filiko/testSieveSorter/docs/SYSTEM.md

# The system: read this first

The one description of what we're building. **If a brief, a doc or the code disagrees with this file, this file wins.** Facts come from the user and the team's photos (Oct 25, 2026), and assumptions are marked. What has been tested, and what hasn't, is in [EVIDENCE.md](EVIDENCE.md).

## 1. The job
- **Input:** a Malaise-trap sample. It's thousands of mostly tiny flies in ethanol, and often a **compacted clump**: a ball or mound of tangled insects, mixed with **leaves, twigs and dirt**.
- **Step 1, the real point of the system:** **break the clump apart, gently.** Specimens go on to imaging and DNA barcoding, so crushed bodies or snapped legs are failures.
- **Step 2:** **size-sort** the freed specimens into classes. BugPicker's are > 6 mm, 2–6 mm and < 2 mm. Leaves are held back on top; dirt goes to the bottom.
- Pasta, rice and quinoa are the bench surrogates for the size classes.

Details: [docs/sessions/clump-breakup.md](sessions/clump-breakup.md).

## 2. The hardware: separate trays, one above the other
- **The stack:** separate holder boxes (about 140 × 104 × 25 mm), each holding one sieve insert (131.4 × 95.4 mm). Coarse is on top, finer below, and a catch pan at the bottom. The breaker layer (step 1) goes on top.
- **The boxes are separate**, stacked one above the other. They aren't one block, and they aren't side by side.

## 3. The motion: each box shakes on its own; sifting is what counts
- **Updated by the user, Oct 27:** "the boxes are individually shaking, it doesn't matter that they're synced, what matters is the sifting." Each box can have its own motion: tilt, vibration, direction, phase. Syncing and alternating aren't requirements. The optimizer picks each box's motion for the best sifting (`sim/BOXES.md`, the `sift` study), with the insects wet (`sim/LIQUID.md`). The hardware then follows the winning motion: one small actuator per box, or a shared drive if the winner allows it.
- **The seesaw below is one option it can choose,** not a constraint. It was the hackathon's working model:
  - **Seesaw, ends tip.** Each tray rocks about **its own pivot across its middle**: a horizontal axis along the tray's width (Y), through its centre. The two short ends (−X and +X) go up and down in turn. **The angle:** **±10° is the default; sweep 5–15°.** ±25° looked too wide in the replays, so don't use 20–30°. Grains slide end to end across the sieve, as in a gold pan; rice on plastic starts sliding at about 22°.
  - **Each level has its own pivot, and neighbours alternate:** opposite phase, so when one tray tips its −X end down, the trays above and below tip it up. The user chose this so material doesn't fly off. Whatever drops from a level lands on a tray tilted the other way.
- **Consequence for the hardware:** when neighbours tilt opposite ways, their facing ends close in by about L·sin θ (L ≈ 140 mm: 48 mm at 20°, 59 mm at 25°, 70 mm at 30°). Measured on the real holder solid (`cad/seesaw_tower.py`, PR #14, 3 mm clearance, pivot assumed at the box centre). The **+X mounting tab** decides the spacing:

  | Tilt | Pitch with the tab | Tab cut off |
  |---|---|---|
  | ±20° | 89.5 mm | 74.4 mm |
  | ±25° | 103.6 mm | 84.9 mm |
  | ±30° | 116.7 mm | 94.7 mm |

  A middle pivot doesn't need the tab, so the seesaw holder (`cad/seesaw_holder.py`) has none. **The build hangs its levels 55 mm apart at ±10°** (`cad/WORKING_DIMENSIONS.md` has the table for every tilt). The sim checks that trays never touch at either end.
- **Not known yet (ASSUMED; sweep them):**
  - the best angle (default ±10°; search 5–15°);
  - the period (the optimizer's seesaw uses 0.4–6 s per cycle);
  - the motion profile: constant angular speed with hard reversals (as the firmware drives its stage) or a smooth sine.
- **Superseded:** earlier notes in this file (rigid up-and-down translation, then "yaw about the +X tab") and the optimizer's default `rock_axis: x` (long sides tipping). The axis is **Y** (the ends tip). The pure translation strokes (`angle_deg`, the firmware stroke, VERTICAL.md, the leaderboards before 10:50) are simplifications; re-check them under the seesaw before the pitch quotes them.

## 3b. The drive for the alternating seesaw (proposed, not built)
This drive only fits the alternating seesaw. If the `sift` study's winning motions differ per box, each box gets its own actuator instead.
- **Two push rods hang from BugSorter's one linear stage.** Rod A, at x = +R, drives levels 0 and 2; rod B, at x = −R, drives levels 1 and 3. Both run on the +Y side, outside the boxes.
- **Why they alternate:** when the stage rises, the levels on rod A lift their +X ends and the levels on rod B lift their −X ends, so neighbours tilt opposite ways.
- **The angle comes from the stroke:** θ = atan(stroke / 2R). It's atan because each rod's cross-pin rides a slot fixed in the box while the rod stays vertical. With R = 56.7 mm, the firmware's default 2 cm stroke gives ±10°. The web app's top and bottom positions set the angle, and its speed sets the period (2 × stroke / speed).
- **Cap the stroke.** At 55 mm spacing, neighbouring boxes touch at a 25.4 mm stroke (±12.6°). Keep it at or under 22.7 mm (±11.3°) for a 3 mm gap. Bigger angles need more spacing: 65 mm for ±15°.
- **The buzz:** a tactile transducer on the rods' yoke, driven by `pi/buzz.py`. It reaches the boxes as a small fast rock (about ±0.35°), not the straight-up shake the sim's best runs used. Mounting it on the base plate would match the sim.
- Geometry, parts and assumptions: [cad/PRODUCT.md](../cad/PRODUCT.md). The sim doesn't model the drive: it prescribes each level's angle directly (section 5).

## 4. Liquid
Samples are in ethanol, and the rig sprays from fixed jets above. `sim/spray.py` models push, wetting and capillary adhesion. Wetting should also weaken clump bonds. `sim/liquid.py` puts the sorter in a bath with a lab-fixed surface (buoyancy, drag, added mass, wetting; `--liquid`); how much of the liquid moves with each shaken box (`entrain`) is unknown and swept ([sim/LIQUID.md](../sim/LIQUID.md)). A bath is slow, though: under ethanol the < 2 mm specimens sink at about 1.4 mm/s, so a submerged tower needs minutes per sort, as EntoSieve's 6 min per plate does (LIQUID.md, "A bath is slow"). The `sift` study sorts wet the way BugSorter does: trays in air, the specimens wet from the sample, the jets spraying ethanol, at a light and a strong capillary cling.

## 5. What the sim models, and what it doesn't
- **Modelled:** the trays (with their real mount point and rocking), the particles (specimens, grains, clumps, debris), the stroke, the spray and, optionally, the liquid bath (no flow solver).
- **Not modelled:** the tool, the motor, the frame, the hand. The frame in the replay (`sim/rig.py`) is display only.
- **The seesaw in the sim:** levels rock **differently** (alternating), so one shared non-inertial tray frame can't do it, and neither can the optimizer's current `rocking()` wrapper, which turns every particle in phase.
  - Run seesaw cases in the **lab frame**, with **each level its own body on a hinge** (axis Y through the level's centre).
  - Prescribe its angle kinematically: write the hinge `qpos` / `qvel` each step from θ_k(t) = ±Θ·profile(t), the sign alternating by level. Gravity stays −Z.
  - Then contacts see the real tray velocities, and nothing approximates the rotation.
  - Translation strokes keep the existing tray-frame path.
- **Recording, so the replay shows each level rocking:**
  - `level_q`: frames × levels × 4 (w x y z), each level's orientation in the lab;
  - `scene["levels"][k]`: that level's `pivot` (mm) and the ids of the geoms that belong to it.
  - The format the viewer reads:
    - `level_q`: frames × levels × 4, w x y z;
    - `scene["levels"][k] = {"pivot": [x, y, z] mm, "geoms": [indices into scene["tray"]["geoms"]]}`;
    - in a lab-frame run, `tray_d` = 0.
  - The display rig (`sim/rig.py`) now hangs each tray on an axle across its middle.
- **Clumps** (clump session): `sim/clumps.py`. Specimens are joined by breakable bonds (`eq_active` off above a force that drops with wetness), with a minimal hook in `sorter.py`'s step loop. Debris: leaf / twig / dirt. See clump-breakup.md part A.
- **The sim ranks designs; it does not predict real percentages until it's calibrated against bench counts.**

## How the work was split
During the hackathon, separate Claude Code sessions owned the seesaw, clumps, the optimizer, CAD and viewing, and physics. Each had its own git worktree. Their briefs are kept in [sessions/](sessions/) as a record.
