filiko/testSieveSorter/cad/out/clamp_ring.png

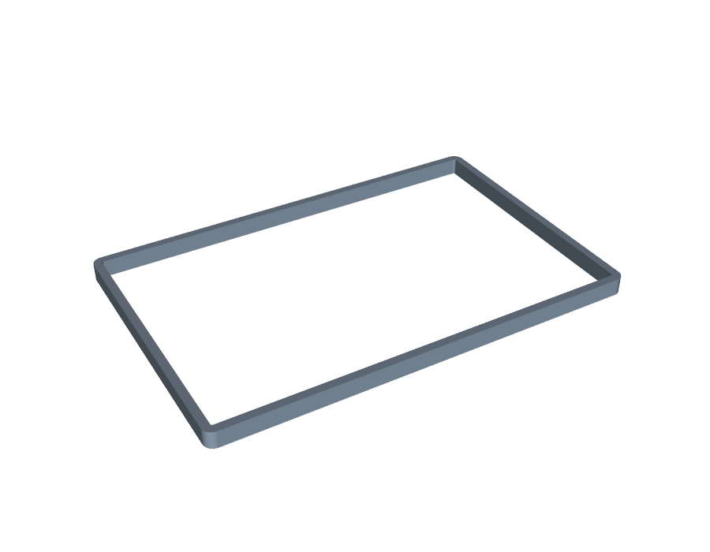
cad/out/clamp_ring.png
