filiko/testSieveSorter/cad/out/gate_t1p2.png

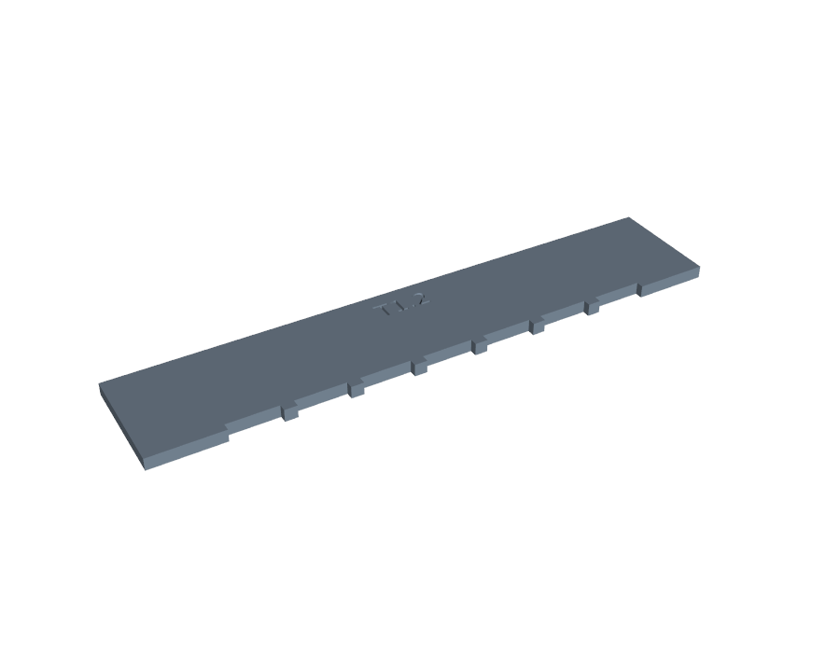
cad/out/gate_t1p2.png
