filiko/testSieveSorter/cad/out/gated_container.png

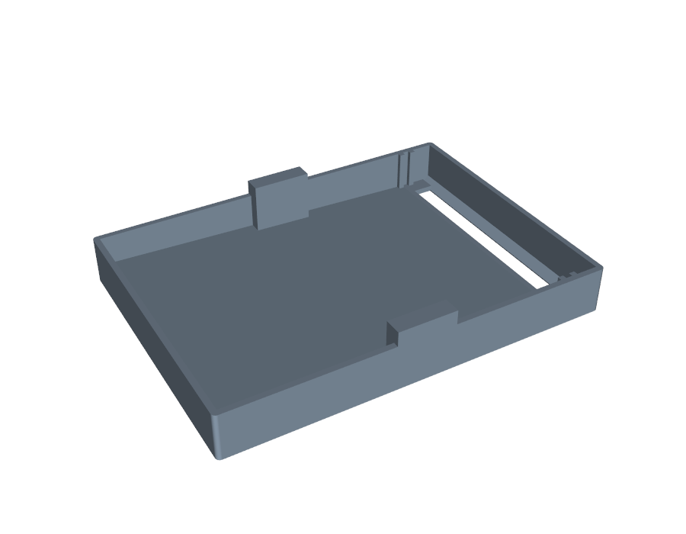
cad/out/gated_container.png
