filiko/testSieveSorter/cad/out/hole_gauge.png

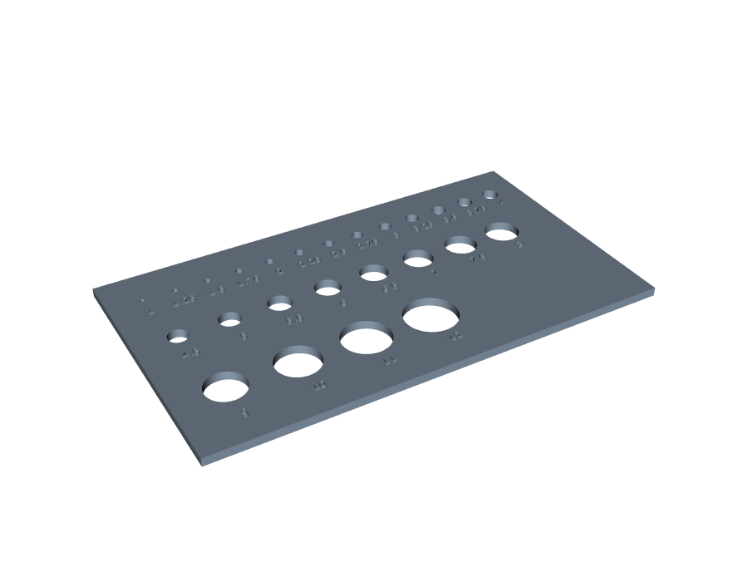
cad/out/hole_gauge.png
