filiko/testSieveSorter/cad/out/layer_1_rods_5p0.png

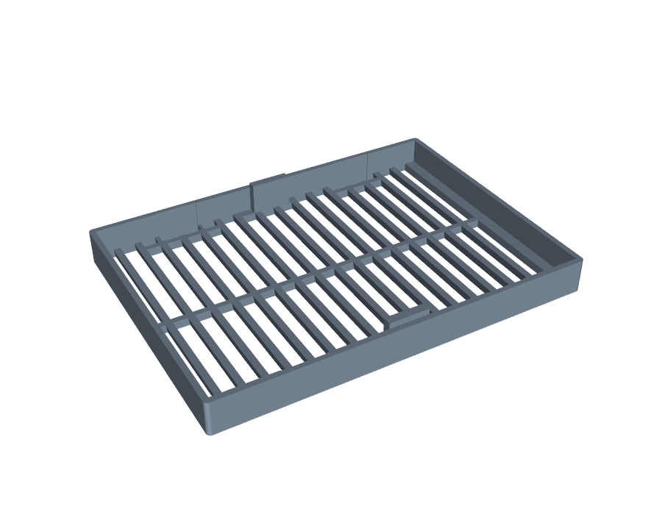
cad/out/layer_1_rods_5p0.png
