filiko/testSieveSorter/cad/out/layer_2_rods_1p4.png

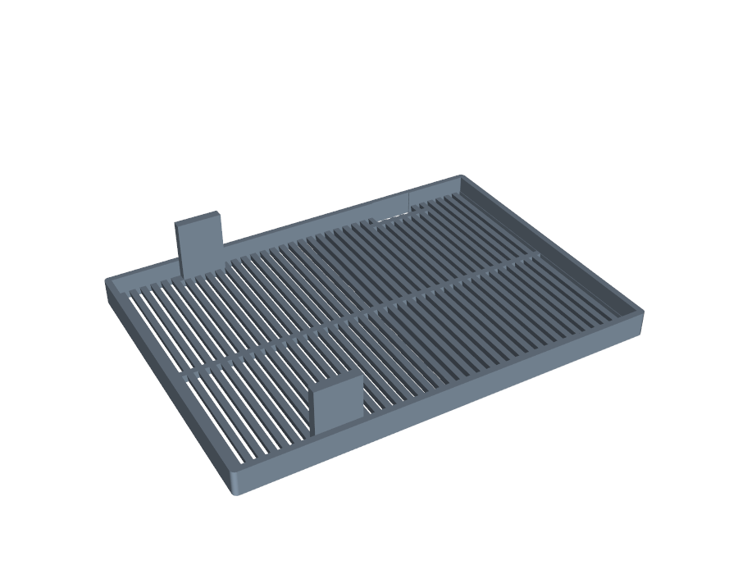
cad/out/layer_2_rods_1p4.png
