filiko/testSieveSorter/cad/out/layer_3_catch.png

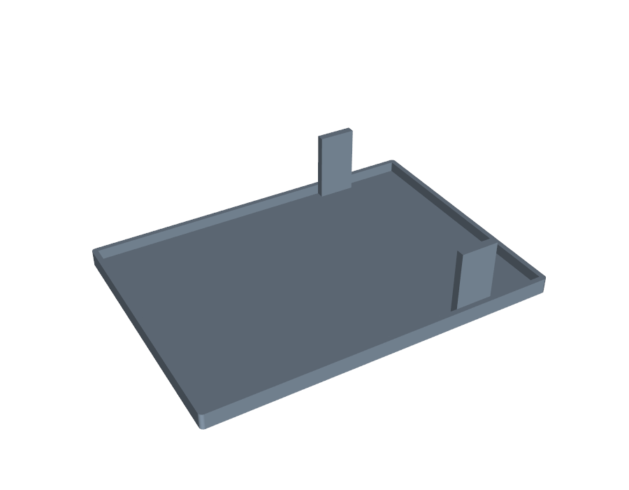
cad/out/layer_3_catch.png
