filiko/testSieveSorter/cad/out/layer_x_square_5p0.png

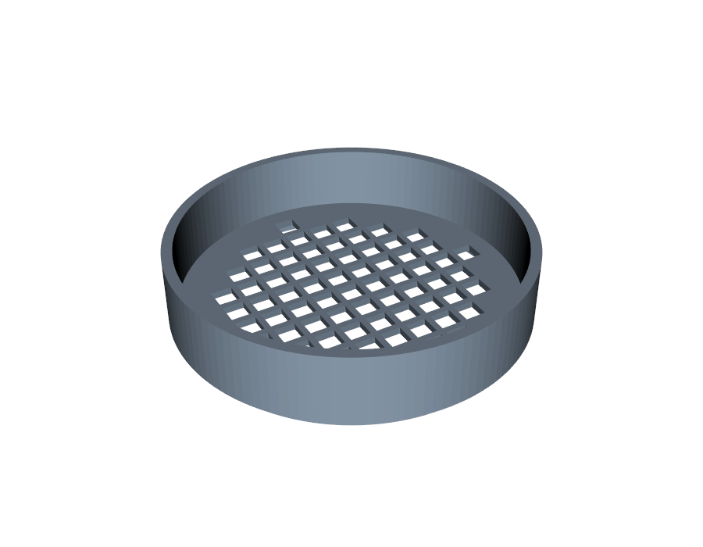
cad/out/layer_x_square_5p0.png
