filiko/testSieveSorter/cad/out/layer_y_square_2p3.png

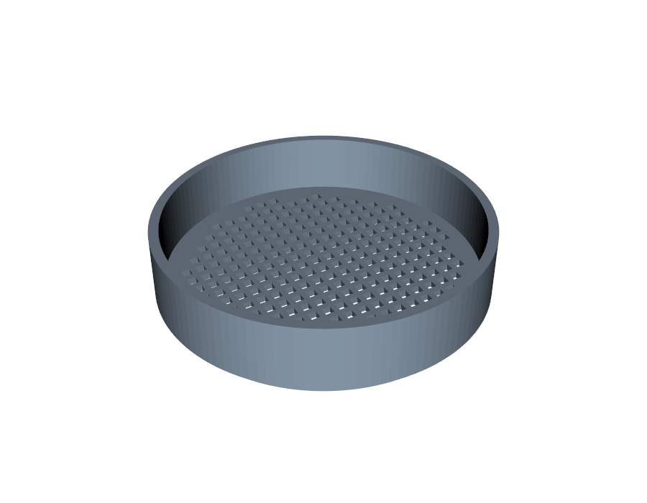
cad/out/layer_y_square_2p3.png
