filiko/testSieveSorter/cad/out/malaise_win1_breaker_o11p3_b1p6_d3p1_h8_p8p5_round.png

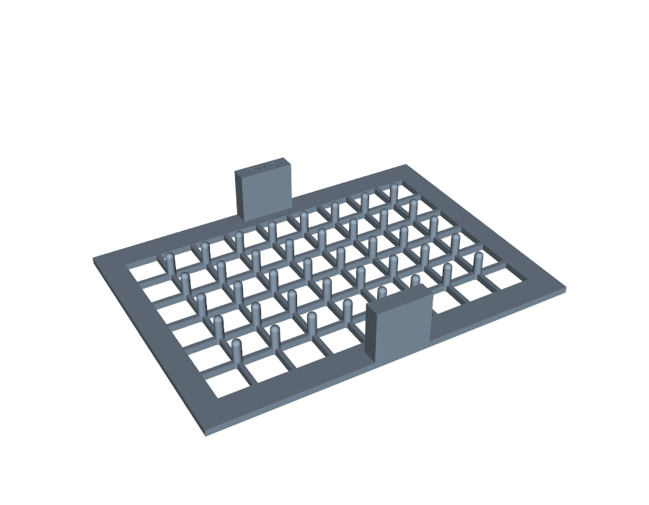
cad/out/malaise_win1_breaker_o11p3_b1p6_d3p1_h8_p8p5_round.png
