filiko/testSieveSorter/cad/out/malaise_win3_breaker_o11p4_b2p3_d1p4_h6p8_p8_round.png

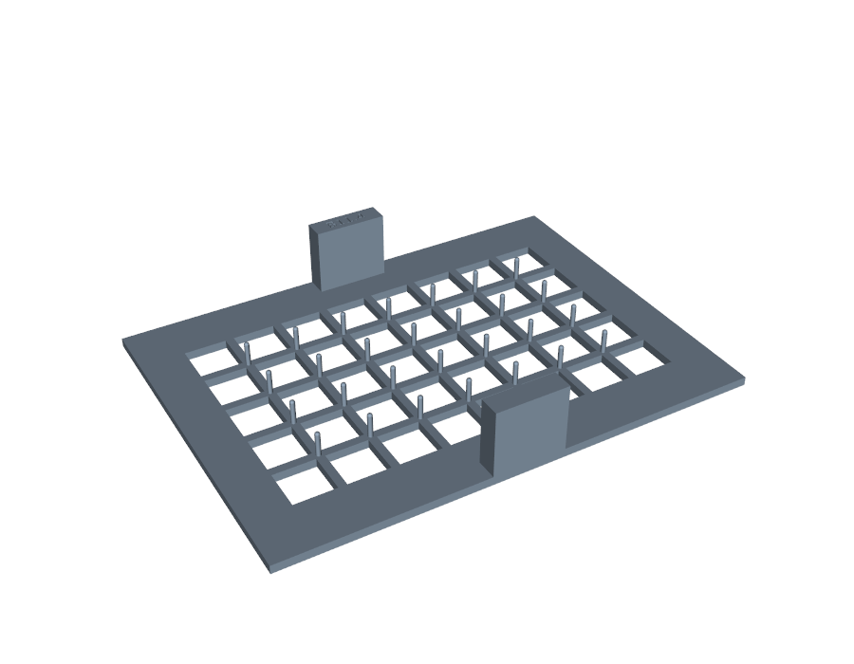
cad/out/malaise_win3_breaker_o11p4_b2p3_d1p4_h6p8_p8_round.png
