filiko/testSieveSorter/cad/out/pool_coupon.png

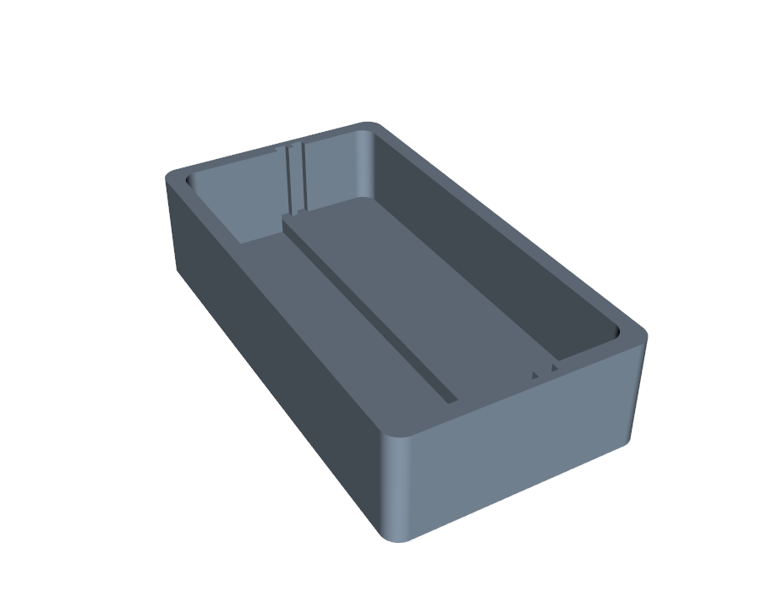
cad/out/pool_coupon.png
