filiko/testSieveSorter/cad/out/product_base.png

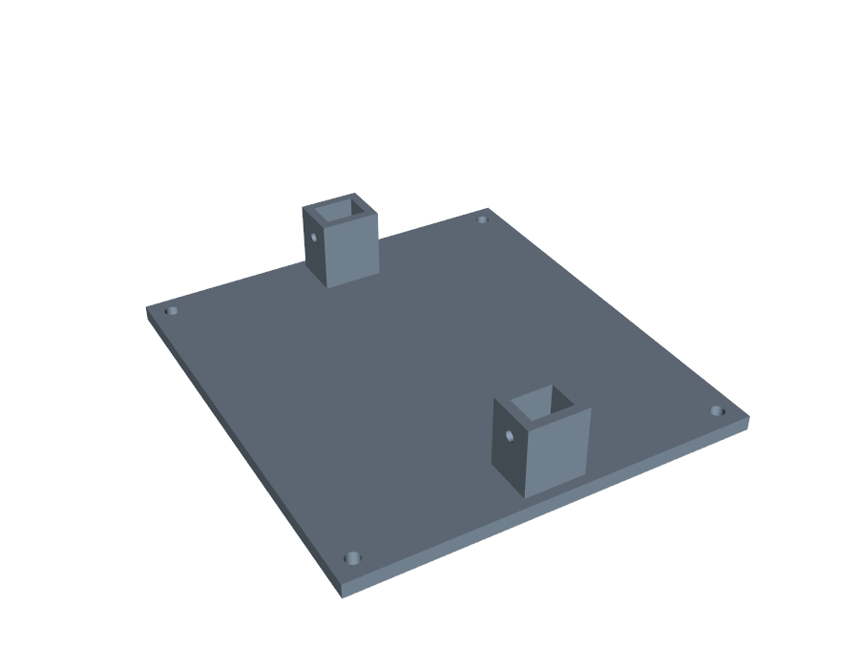
cad/out/product_base.png
