filiko/testSieveSorter/cad/out/product_post.png

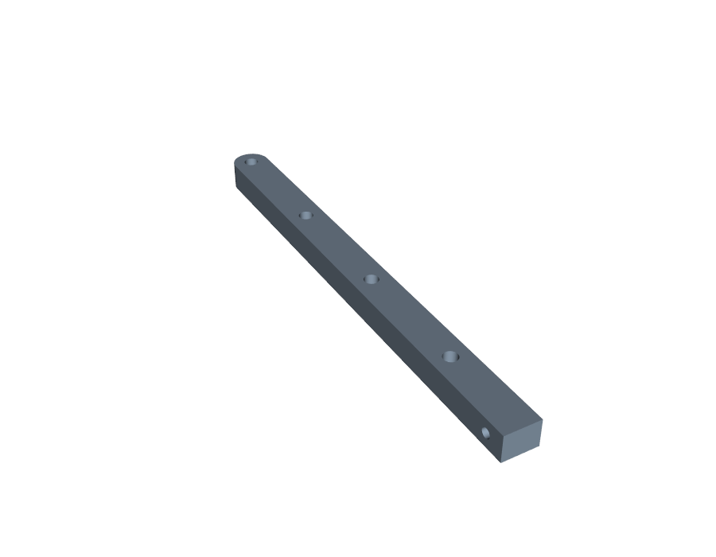
cad/out/product_post.png
