filiko/testSieveSorter/cad/out/product_yoke.png

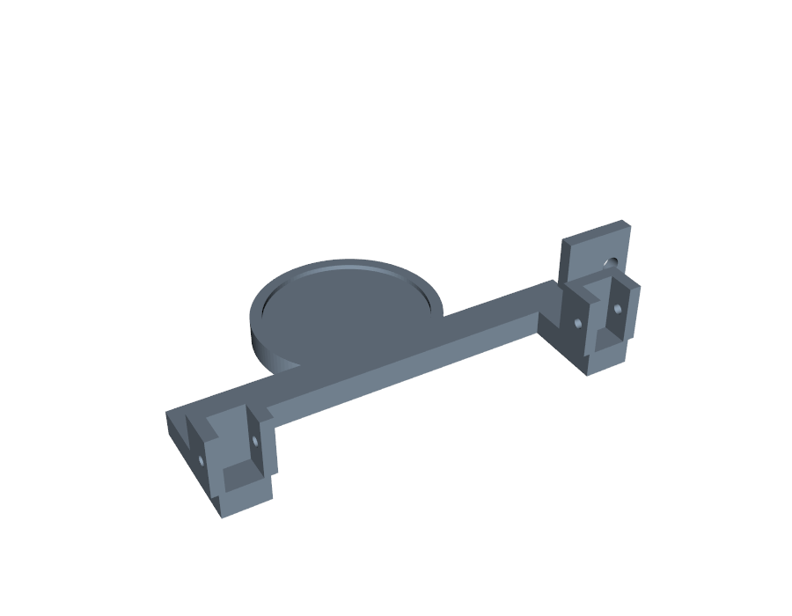
cad/out/product_yoke.png
