filiko/testSieveSorter/cad/out/round_lid.png

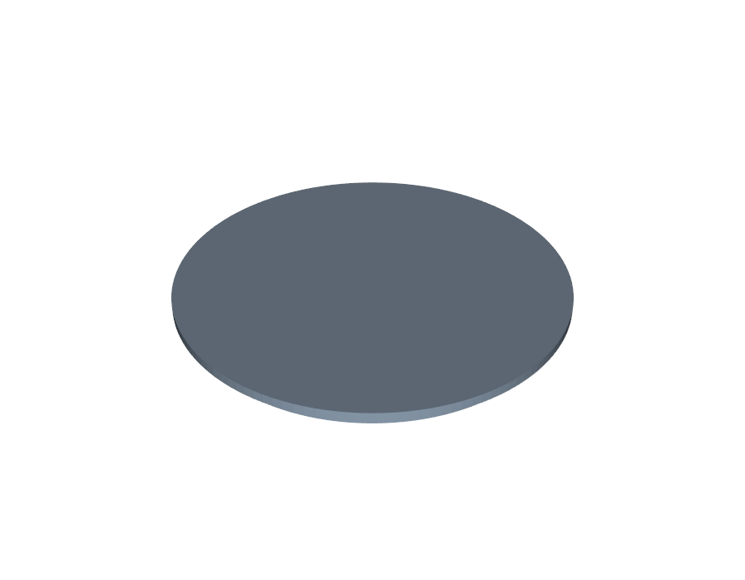
cad/out/round_lid.png
