filiko/testSieveSorter/cad/out/seesaw_catch_pan_drive_b.png

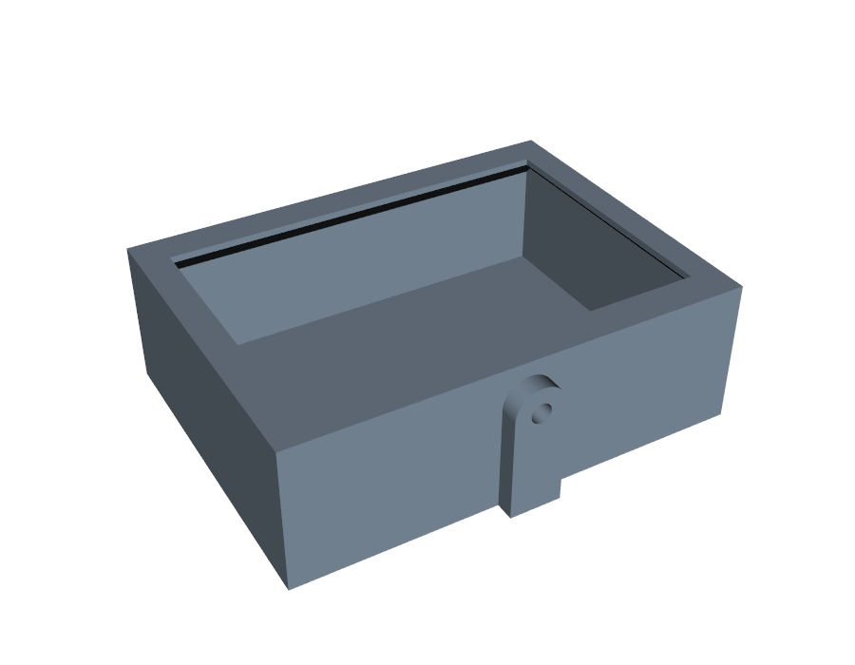
cad/out/seesaw_catch_pan_drive_b.png
