filiko/testSieveSorter/cad/out/seesaw_tower.png

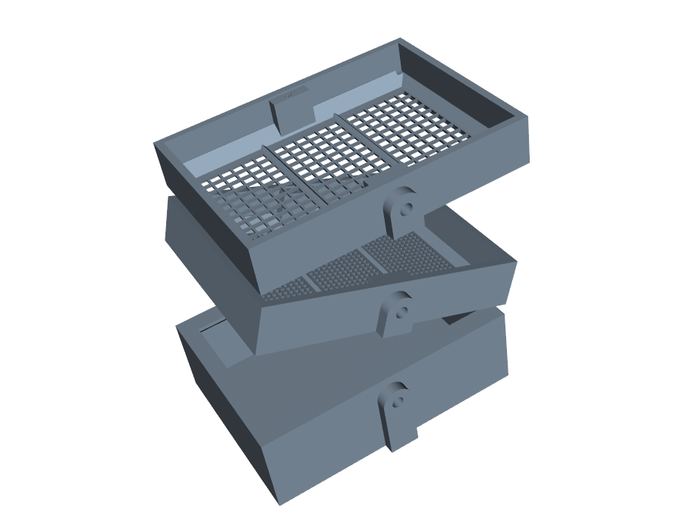
cad/out/seesaw_tower.png
