filiko/testSieveSorter/cad/out/tier_coarse.png

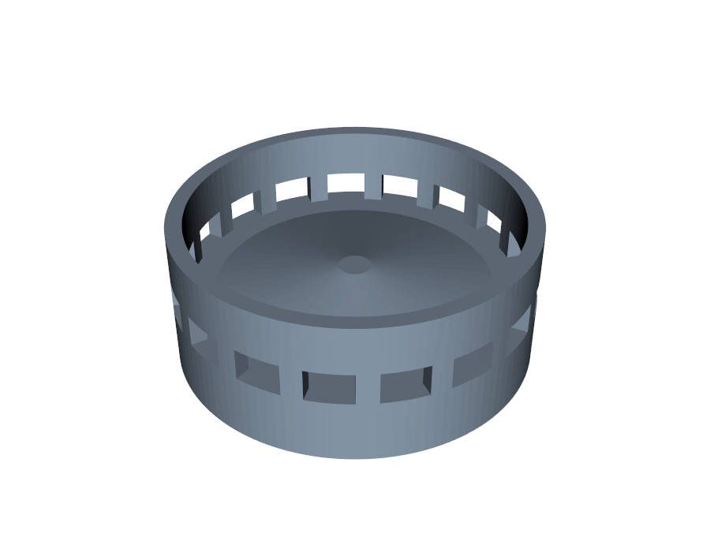
cad/out/tier_coarse.png
