filiko/testSieveSorter/cad/out/tier_fine.png

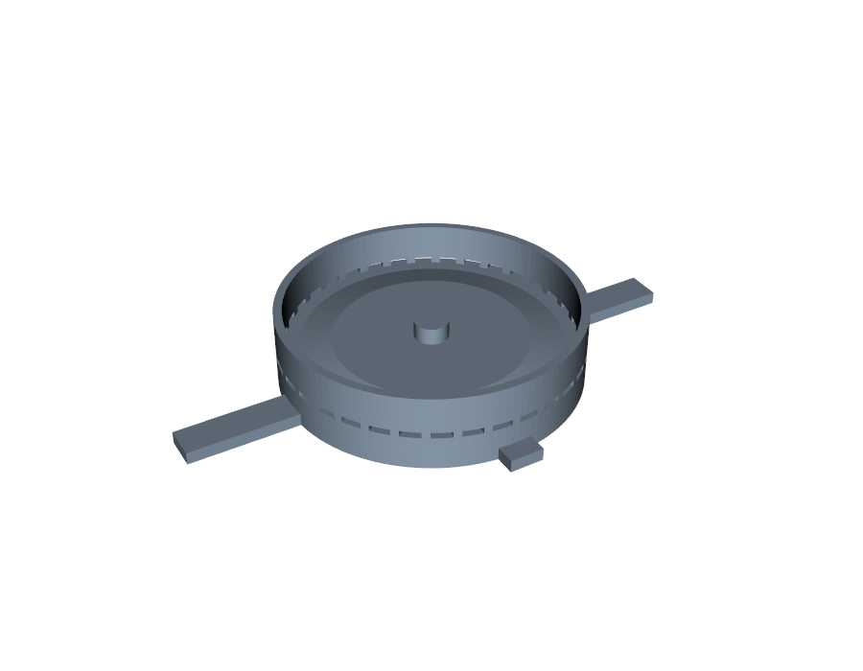
cad/out/tier_fine.png
