filiko/testSieveSorter/docs/assets/product.stl

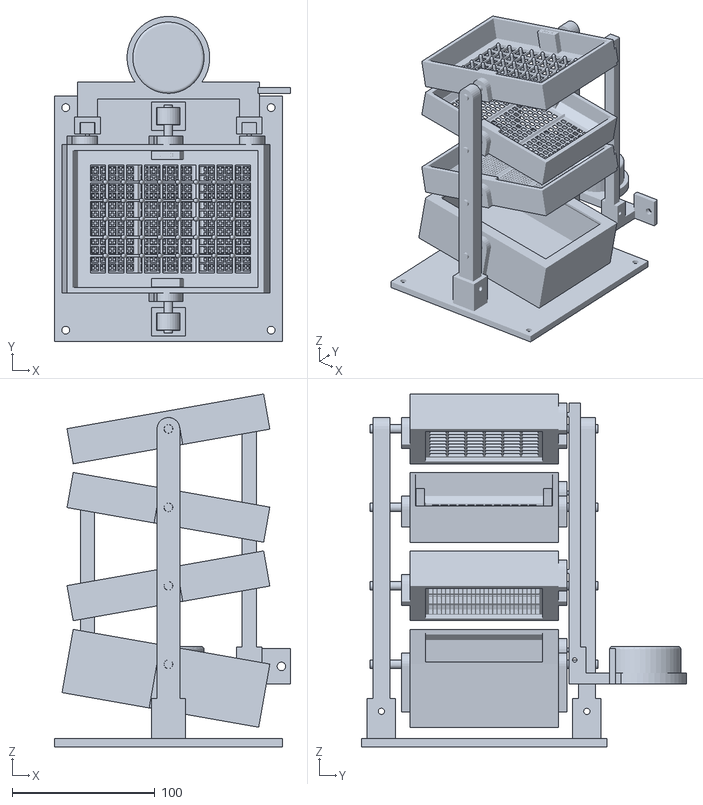
[picture p33: CAD file, 2026-10-28]
docs/assets/product.stl
165.7 x 227.9 x 247.5
