filiko/testSieveSorter/(commit log)

2026-10-24 Add BugSorter gates verdict, sources and Codex review
    Verdict on the "gates" sieve idea for BioKEA's BugSorter, reconciled
    across Claude, a Fable 5.1 agent and Codex Astra: gates are an
    experiment for the coarse cut, perforated inserts over isolated
    collectors are the safe build, and one-way flow through the openings
    is what decides whether horizontal motion works.
    Includes a sourced comparison of BioKEA's current system (deck,
    BugSorter firmware, BugPicker repo, biokea.ai) against our idea, the
    Codex brief and its verbatim answer, and the earlier line-breakdown
    report.
2026-10-25 Add 24-well-plate-sized sieve system CAD
    CadQuery script for a nesting sieve stack where every part is exactly
    the 24-well plate envelope (127.76 x 85.47 x 20.27 mm): lid, 5.0 mm
    coarse tray, 2.3 mm round and 1.3 mm slot fine trays with holes that
    widen downward, a sealed collector, an open frame plus clamp ring for
    the kit's metal sheets, and 2.3/5.0 mm gate coupons (raised deck,
    tapered posts, drop into a pocket) to test the gates idea side by side.
    Copies cadkit.py, hole_gauge.py and slice.py from BioKEA-hack\cad.
    Meshes are rebuilt by the script and not tracked; previews and checks
    are.
2026-10-25 Add concentric gate sorter (rings) to sieve CAD
    One plate-sized part: a 40 mm centre, a ring of 5 mm gates, a ring of
    1.3 mm (or 2.3 mm) gates, and floors that step down 3 mm per zone so
    passed grains cannot climb back. Gates widen outward against wedging.
    Prints flat and upright with no supports.
2026-10-25 Add pool sorter: one plane with swappable gate strips
    One open plate-sized plane, shaken along X, floor stepping down 3 mm at
    each gate. Gates are 2 mm strips that slide into side-wall grooves and
    lift out, so sizes can be swapped without reprinting the tray and each
    fraction can be poured out in turn. Width gates (gaps 5.0/3.0/2.3 mm) cut
    by width; tunnel gates (1.2-3.0 mm high) cut by the thickness of
    flat-lying grains, which is what separates long-grain rice from quinoa.
    Strips print flat so opening width and height are both in XY. A cover
    groove upstream of each gate takes a dam strip to close the gate before
    pouring. pool_coupon is one slot, to check the fit first.
    Reviewed twice by Co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
2026-10-25 Replace flat ring sorter with tiered concentric sorter
    The flat rings had no push toward the gates and used tall slits that
    only pass grains standing on edge, which shaken grains never do.
    tiered_sorter.py builds two stacking tiers for the plate-sized
    collector. Each tier floor is a 10 degree cone so shaking walks grains
    to the rim; gates are low tunnels at floor level (height = thickness
    cut, width = width cut); passed grains drop 8 mm onto the tier below.
    Coarse: 40 mm cone, 5.0 x 4.0 mm tunnels. Fine: 66 mm cone, 4.0 x 1.4
    mm tunnels. A peg centres the coarse tier, feet centre the fine tier.
2026-10-25 Add round layer stack: full layers with gates in each floor
    Same-size round layers (85 mm, 24-well plate height) that nest: a 5.0 mm
    square-gate layer keeps pasta, a 1.4 x 10 mm slot layer keeps long-grain
    rice and passes quinoa (or a 2.3 mm square layer for short-grain rice),
    then a collector and a lid. Gates widen 8 degrees downward. Prints flat
    with no supports. Includes a cut-away preview of the stack.
2026-10-25 Add frame holder rebuilt from the shared drawing
    The friend's ChatGPT share link has no downloadable files, so this
    rebuilds the FRAME HOLDER drawing: 140 x 104 x 25 mm body, 122 x 82 mm
    open centre, U finger notches in both long walls, 22 mm tab with a
    6 mm hole. Wall thickness and ledge height are guesses, named at the
    top of the script.
2026-10-25 Add plinko layers that stack inside the frame holder box
    Three drop-in layers replace the glued-mesh inserts: rods with a 5.0 mm
    gap (pasta stays), rods with a 1.4 mm gap (long-grain rice stays), and a
    solid catch tray on the ledge (quinoa). Rods run across the shake and
    narrow 8 degrees downward. Each layer is a walled tray with pull tabs at
    its own x position; lower tabs pass through 0.3 mm-clearance slots in
    the layers above, so layers lift out top-down with their catch. Sizes
    follow frame_holder.py.
2026-10-25 Add printable sieve inserts for the holder box
    Recreates BioKEA's flat 2x3-window inserts with pull tabs from the
    bench photos, with the mesh printed as square holes: 5.0 mm (150 holes)
    and 2.0 mm (726 holes). The screen sits at the bottom of each window so
    it prints on the bed without bridging; holes widen 8 degrees downward.
    Outside size follows the frame_holder.py pocket.
2026-10-25 Adopt holder and insert sizes as working dimensions
    WALL and LEDGE_T in frame_holder.py and the sieve insert sizes are now
    the team's working values, listed in cad/WORKING_DIMENSIONS.md. README
    notes that each STL is a separate part: load multiple files in Bambu
    Studio as separate objects, then Arrange.
2026-10-25 Add gated container: drop-in gated replacement for the mesh inserts
    Same 131.4 x 95.4 mm footprint and pull tabs as the current inserts,
    shaken longways. Solid floor sloping 2 degrees toward a swappable gate
    strip at the +X end; a drop slot past the strip sits over the box's
    open bottom so passed grains fall to the next level, with a 45 degree
    ramp at the end wall. Gate strips print flat: width gaps 5.0/3.0/2.0 mm
    and tunnels 1.2/1.4/1.6 mm. Flip the container on alternate tower
    levels so drops land on solid floor. Includes a cut-away preview in the
    holder box and the dimensions in WORKING_DIMENSIONS.md.
2026-10-25 Add sieve-gate-design skill: sample spec to tested gate sizes
    Project skill that takes sample information (item length/width/thickness,
    counts, target plate, desired classes) to one gate per tower level:
    - gatecalc.py plans and checks gate sequences with geometric passability
    rules (flat and rolled-on-edge cases, print undersize and tolerance
    margins) and 96-well fit rules (Greiner plate data), and summarises
    sim runs;
    - references for passability, well fit, and the sim/CAD commands;
    - spec templates for the pantry test and Malaise insects, and a run log
    template so the next agent can continue.
2026-10-25 Add MuJoCo sorter sim, bench templates and Pi buzz script
    Carried over uncommitted from the previous machine as-is.
    [bench_counts.csv, clear_times.csv, grain_dims.csv, jets.csv, openings.csv, stroke_example.csv, tilt.csv]
2026-10-25 Rebuild gated container in WSL, slice on Windows with Bambu Studio
    Smart App Control stays on: cadquery builds in a WSL2 Python 3.12 venv
    and slice.py drops its cadkit import so it runs on the Windows venv.
    Rebuilt gated_container, gate strips and gated_preview; added hole_gauge
    preview. Records the WSL setup in docs/sessions/README.md.
2026-10-25 Document that the bench prototype ran on a handheld DeWalt tool, not the stepper
    Forum's photos show the printed tray bolted onto a DeWalt 20V MAX cordless tool.
    The only clip shows it idle, so no stroke can be extracted yet.
2026-10-25 Viewer: camera from the URL, Copy camera, Record; frame-exact clip export
    viewer_template.html
    - Reads cam=x,y,z, target=x,y,z, fov and aspect from ?query or #hash; the
    old #t, play, lock and kind options work from either.
    - Copy camera copies the page URL with the current camera; FOV input dollies
    so the tray keeps its size; Frame sets the view aspect to match a photo.
    - Record plays the run once in real time and downloads a .webm (VP8 first,
    it drops fewer frames than VP9), with the zone labels and sim clock drawn in.
    - viewerExport hook renders any sim time to a JPEG, for record_view.py.
    record_view.py drives the page headless over CDP (websockets, already in the
    venv) and pipes ev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
2026-10-25 sorter: stroke angle_deg (0 = flow axis, 90 = straight up) for vertical and angled strokes
2026-10-25 Real-vs-sim side-by-side from Forum's clip (media/demo_side_by_side.mp4)
    Forum's IMG_1319.MOV is a 1.1 s iPhone Live Photo (portrait 1080x1920 at
    30 fps). Both halves run at 1/4 speed over the same 1.1 s of physical time,
    looped 3x: 1216x1148, 13.2 s, 7.8 MB.
    - Sim camera matched by eye: azimuth -45 deg from +X (mounting tab nearest the
    phone, pull tabs on the up-right line), 58 deg down, 66 deg FOV, 9:16.
    - Sim segment t = 2.0-3.1 s of current_mesh, where the sort is in the same
    state as the video (pasta on the top mesh, small grains through).
    - side_by_side.py: --slow, --loops, --caption (in its own bar, clear of the
    sim clock); labels sized to fit narrow portrait halves; phone rotat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
2026-10-25 Add the gated container tower to the sim and a sim-driven design optimizer
    sim/designs_gated.py builds gated:<slope>,<strips>[,key=value] from cad/gated_container.py:
    one holder box per level, flipped levels, catch pan, zones L1..Ln and catch.
    sim/optimize.py searches the gated, plinko and inserts families (plus the
    firmware stroke) across 3 friction sets x 3 seeds with successive halving,
    Latin hypercube and cross-entropy rounds, and writes sim/opt/ outputs.
    designs.build gets a three-line hook for gated:. sweep.py is imported, not edited.
2026-10-25 Vertical/angled stroke comparison on the demo tray, stability probe, PERF.md
    - sweep.py vertical preset: inserts:5mm, pasta + rice, 0/45/90 deg at equal peak acceleration, 3 friction sets
    - instab.py: stroke list, demo mix
    - VERTICAL.md: results, assumptions, solver recommendations for vertical strokes
    - PERF.md: reference run, worker scaling, instability findings, chosen defaults
2026-10-25 Optimizer: per-study ranges, stroke stress test, two tested structural options
    designs_gated.py gains rib= (ratchet floor) and gx= / slot= per level / flip=0
    (mid-slot tower). Both were tested and rejected (sim/opt/LOG.md); the default
    geometry is unchanged, checked against the previous build. optimize.py gains
    per-study search ranges and insect baselines, a gated_rib family that is off by
    default, and 'stress', which reruns the leaders at other stroke reversal times.
2026-10-25 Gated tabs clear the box above; tower view; build + slice optimizer winners
    - gated_container: pull tabs topped out 3 mm above the holder rim, so in the
    rim-on-rim tower they hit the side ledge of the box above (the sim had to
    cut them: TAB_CLASH). TAB_TOP is now box.H - LEDGE_T - 1 = 21, 1 mm under
    the rim like the inserts; the finger notches sit over them. Re-sliced on
    the P1S: 65 min, 47.0 g (was 67 min, 47.5 g).
    - gated_container.tower(): cut-away of the assembled tower (holder per
    level, alternate levels flipped, catch pan) -> out/gated_tower.png.
    - build_winners.py (WSL): builds each winner in sim/opt/winners.json from its
    "cad" block (gated constants + STRIPS, plinko LAYER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
2026-10-25 Demo-rig visual: vertical demo-tray run next to Forum's photo; stop tracking the clip
    demo-rig.md part D: Forum's IMG_1316.JPG (the bench prototype on the tool,
    side view) next to the inserts:5mm run shaken up and down (VERTICAL.md's
    viewer run, recorded at 240 fps so the 20 Hz stroke doesn't alias), camera
    matched by eye, sim t 0-2.2 s at 1/5 speed, captioned with the pour/shake
    timeline and the assumed stroke. 1440x1052, 11 s, 1.5 MB.
    - media/demo_side_by_side.mp4 is no longer tracked: media/ is gitignored on
    main (Forum's footage stays local), but PR #1 had committed the earlier
    video-based clip. It is still in history (private repo).
    - side_by_side.py: a photo as --real is held for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
2026-10-25 First optimizer leaderboard: plinko rods lead, gated tower is transport-limited
    Round 0 of the demo study: 51 candidates (gated, plinko, inserts, plus fixed
    references), 603 runs over 3 friction sets x 3 seeds, 8 s screen then 30 s
    full runs. Best: plinko rods 5.1 / 1.7 nominal, 14 mm at 41 mm/s, robust 0.891
    (rice 97/97, quinoa 97/96 purity/recovery). sim/opt/LOG.md records why the
    losers failed, two rejected structural tests (ratchet floor, mid-slot tower)
    and the winners rule. optimize.py adds a working-sorter floor for winners and
    a print-tolerance stress test.
2026-10-25 Optimizer round 1, stroke angle and tool drive in the search, demo-rig baseline
    Round 1 (cross-entropy) leader: plinko rods 5.6 / 1.6 on the firmware cap
    stroke, robust 0.915. From round 2: firmware or vibrating-tool drive with a
    0-90 deg stroke angle (main's angle_deg), the demo rig (inserts:5mm, up and
    down) as a reference row, the unflipped mid-slot tower as family gated_mid,
    and sorter.py's unstable_resets counted as failures.
2026-10-25 Optimizer: adopt bambu's two-line printability rule; gated_mid CAD block buildable-safe
    Rods, teeth and bars must be at least 0.8 mm (two print lines) at the bed, per
    cad/build_winners.py on bambu-viz. Winner selection re-checks constraints, which
    drops two thin-rod plinko candidates from winners.json (they stay on the
    leaderboard).
2026-10-25 The rig is separate trays stacked one above the other: use inserts:5mm,2mm, not one tray
2026-10-25 contact_rule.py, verify.py; instab: overlap per tray role, every step
    - contact_rule.py: picks (dt, timeconst) from a design's tightest clearance and its
    stroke, from a measured table (instab.py on inserts:5mm, pool:w5p0,t1p4 and plinko,
    7 strokes x 3 settings, 378 runs, no resets).
    - instab.py: worst overlap per tray role after the settle, read every step; wraps the
    original mj_step (the pool reuses worker processes, which chained the wrappers);
    --retry redoes only the runs that failed.
    - verify.py: second opinion on the optimizer's winners (fresh seeds, heavy load,
    per-design contacts, one setting stiffer); imports optimize.py, doesn't edit it.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
2026-10-25 Optimizer round 2: vibrating-tool drive wins; unflipped mid-slot gated tower works with an angled throw
    Top: plinko 3.7/1.5 on a 48 Hz, 2.2 g, 20 deg sine, robust 0.999; gated_mid at
    0.955 (vs 0.07 for any gated design on the firmware stroke). The flagged leaders
    are queued for a stiffer-contact verification before they can be winners.
2026-10-25 Optimizer: verify flagged leaders at stiffer contacts; best design per drive
    verify reruns flagged leaders at dt 0.125 ms / timeconst 0.25 ms; a design that
    comes back clean counts as clean in winners.json, ranked by the lower score.
    winners.json and the leaderboard gain the best design per drive (firmware stage
    vs vibrating tool). stress also covers the current winners.
2026-10-25 Stacked demo rig (inserts:5mm,2mm): direction decides the 2 mm tray; contact rule table
    - VERTICAL.md: the vertical comparison on the stacked trays with pasta + rice + quinoa
    (216 runs, 0 resets). Pasta always stays on 5 mm. Along the tray, 86-90% of the rice
    stays on 2 mm; a 2 g throw or straight-up stroke stands rice on end and it keeps
    leaking through (16% left after 10 s straight up). As printed (1.85 mm holes), 94% /
    75% / 64%. Contacts don't decide it.
    - VERTICAL.md, Contact rule: overlap on opening surfaces read every step, 3 designs x
    7 strokes x 3 settings (378 runs, 0 resets); the optimizer's 10th-step gate reading is
    1.2-1.5x low; plinko rods take 0.092 mm under the fi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
2026-10-25 Optimizer: exploratory insect leaderboard (round 0)
    Best: plinko on a near-vertical 32 Hz, 4 g vibration, robust 0.351; no design
    reaches the working-sorter floor, since gates cut width/thickness while the
    classes are body length. Today's mesh jams 17 specimens per run.
2026-10-25 Optimizer: verification at stiffer contacts clears the top plinko (1.000)
    P-ae394887 (plinko 3.7/1.5, 48 Hz 2.2 g 20 deg sine) and P-547508e5 come back
    unflagged at dt 0.125 ms and become winners #1 and #3; the firmware-stroke
    plinko P-ba5dd6b3 stays #2.
2026-10-25 Optimizer: the demo rig is the stacked 5 mm / 2 mm trays (main's 06:20 correction)
    Adds the stacked rig on its up-and-down tool stroke as an inserts-family baseline
    (joins in round 4); the single 5 mm tray row is relabelled as one level of it.
2026-10-25 Optimizer round 3: unflipped mid-slot gated tower scores 0.985 clean (winner #2)
    gated_mid with tunnels 3.5 / 1.6, L1 gate at x 22.2 (slot 8.1), unflipped, on a
    48 Hz, 3.7 g, 30 deg throw: every class 100% in all 9 runs, no flags. It needs
    the mid-slot CAD change described in LOG.md. Also fixes per-level locations in
    the failure analysis.
2026-10-25 Optimizer: stress test results; fix stress/verify scoring; winners by worst case
    Stress and verify summaries used the screen's progress score instead of the
    strict score; recomputed from the cache. Winners now rank by the worst robust
    score across all checks run on them (friction x seeds, stiff contacts, printer
    undersize, stroke reversal). P-fdf86953 drops (rice leaks if openings print
    0.1 mm wide). Top 6 queued for stress so the final comparison is fair.
2026-10-25 Optimizer round 4: second perfect plinko (20 Hz along the tray); firmware best 0.958; demo rig 0.46
    The stacked demo rig (5/2 mm trays, up and down) loses 39% of the rice into
    quinoa's bin through the 2 mm holes.
2026-10-25 Optimizer: all winners stress-tested; plinko L2 gap 1.5-1.6 mm (1.7 leaks rice if printed loose)
    Winners: plinko 3.7/1.5 (vibrating tool, worst 0.978), gated_mid (vibrating
    tool, worst 0.925), plinko 5.6/1.6 (firmware stroke, worst 0.870).
2026-10-25 Optimizer winners built and sliced: print plan, mid-slot gated container, one plate per winner
    - sim/opt/print_plan.md: the three demo winners from main's winners.json, each part sliced for the P1S,
    plus one arranged plate per winner (cad/out/slice/win<rank>_plate.gcode.3mf, local): 124 / 133 / 152 min,
    80.5 / 88.7 / 103.8 g. All checks pass, no printability flags. The plan now gives the stroke in words
    and winner 3's assembly order.
    - gated_container.py: container(gate_x, slot) builds the optimizer's mid-slot container (LOG.md, demo
    round 3): gate anywhere clear of the tabs, a slot of any length, then a 30 deg wedge capped 2 mm under
    the wall top, as in sim/designs_gated.py. tower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
2026-10-25 Optimizer round 6: today's flipped gated tower (t5.3 / t1.6, 38 Hz 4.8 g flat shake) at 0.950 clean
    Buildable with gated_container.py constants and two new strips; stress test queued.
2026-10-25 Verify the optimizer's 07:14 winners (sim/opt/VERIFY.md); contact rule picks too soft for the stack
    verify.py: contact probes batched into one run; --report runs nothing and writes what is cached,
    listing missing runs; --variants; a hand-written reading between summary markers survives a rewrite.
    The run stopped at 200 of 234 (low memory); the three winners are complete.
2026-10-25 Optimizer: seesaw (rocking) drive for the rig's current motor
    Tilts gravity in the tray frame and applies the rotating-frame forces per
    particle (Euler, centrifugal, Coriolis), on the firmware's constant-speed,
    hard-reversal profile; pivot axis, amplitude and period are searched.
    winners.json gains a seesaw entry in best_by_drive. A round with every
    candidate on the seesaw drive is running.
2026-10-25 Bench tower in the sim and the replay: spaced holder boxes (pitch=), display-only frame, tub and spray plate
    - designs_holder.py: inserts:...,pitch=<mm> hangs the holder boxes apart (bottom to bottom) instead of
    rim on rim, as on BioKEA's tower frame, with an invisible tub floor for grains that bounce out through a
    gap (counted lost). Without pitch the design is unchanged (same 174 geoms, same zones).
    - rig.py (new): the BugSorter tower as display-only geoms: extrusion frame, a rod and knob through each
    box's tab, hex spray plate, controller, tub with water, acrylic. Sizes estimated from the team's photo.
    - viewer.py --rig bugsorter adds it to the replay; the template draws it fixed in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
2026-10-25 The real problem is the clump: brief for a breaker stage (sim clumps + debris, breaker CAD, malaise study)
    Malaise samples arrive as a compacted ball of insects with leaves and dirt.
    Breaking it apart gently is the system's first job; sorting comes after.
2026-10-25 docs/SYSTEM.md: one shared description of the system; boxes are held at the +X tab and rock
    Sessions had drifted apart on what the rig is. SYSTEM.md is now the source of
    truth every brief points to: clump input, separate stacked trays, each held only
    at its short-end tab and overhanging so it rocks about the mount (not a rigid
    translation), what the sim models, and who owns what. Physics gets the rocking
    stroke first; bambu's tower replay must show rocking; optimizer re-scores under it.
2026-10-25 SYSTEM.md: the box is clamped and flexes up to 20-30 deg either side in yaw about the +X tab
2026-10-25 Replay rocks the tray when a run records it; translation-only clips flagged as not the real motion
    - viewer.py / viewer_template.html: an optional tray_q (frames x 4, w x y z) is the tray frame's
    orientation about scene["tray"]["pivot"] (tray frame, mm); the page draws a tray-frame point at
    tray_d + pivot + R (x - pivot), slerping between frames. Runs without tray_q play as before.
    Checked on a synthetic +/-5 deg pitch about a tab rod: the boxes swing about the rod, the rig stays put.
    - sim/README.md: both real-vs-sim clips slide the trays up and down as one block, which is not the
    real motion (SYSTEM.md section 3); they are re-rendered once the rocking stroke lands.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
2026-10-25 SYSTEM.md: one pivot for yaw (tabs line up vertically); recording keys the viewer reads
2026-10-25 Breaker layer CAD (clump-breakup.md B.1-B.3): parametric, default built and sliced, in the print plan
    - cad/breaker_layer.py: breaker:open,bar,pin_d,pin_h,pitch,tip, the same names as the optimizer's sim
    spec. A sieve-insert drop-in (131.4 x 95.4, same tabs): square grid GRID_T 2.4 thick, round pins on the
    grid nodes every k = round(pitch / (open + bar)) nodes, built from the bed up, round tip as a fillet
    0.05 mm short of the radius (a sphere on a cylinder left the mesh open). Openings round to 0.1 mm,
    pin heights to 0.2 mm layers. Flags: bars or pins under two lines, pins over 8 diameters tall, pin
    tops above the box rim. The docstring spells out the geometry for the sim to mirror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
2026-10-25 SYSTEM.md: the motion is a seesaw (ends tip, pivot across the middle), each level alternating
    Confirmed by the user with a diagram at 10:50: each tray rocks +/-20-30 deg about
    its own pivot across its middle (axis Y), neighbours in opposite phase so material
    doesn't fly off. Supersedes rigid translation and 'yaw about the tab'. Adds the
    level-spacing consequence, lab-frame hinged levels for the sim, per-level recording,
    and a new seesaw session that owns it; physics does clumps.
2026-10-25 Optimizer round 7: the seesaw drive; plinko 3.1 / 1.6 rocked +/-19 deg at 0.4 s is the design for the rig's motor (0.835)
    Final round of the session. Gated designs can't sort on a symmetric seesaw;
    today's mesh and demo trays keep 65-83% of the rice on a default seesaw.
    The winner sits at the amplitude and period bounds and is not yet stress-tested.
2026-10-25 Optimizer: the rig's seesaw axis is y (ends tip), per SYSTEM.md; best-per-drive counts only y-axis runs
    Round 7's +/-19 deg x-axis winner rocked the wrong axis. Under y the best is
    plinko 3.3 / 1.7 at +/-14.5 deg, 0.9 s (0.705, flagged 2/9), so winners.json
    has no clean seesaw entry. ROCK_DEFAULT is y at 20 deg; rock_deg now goes to 30.
2026-10-25 Replay draws each level seesawing about its own pivot (SYSTEM.md 10:50); rig pivots across the middle
    - viewer.py / viewer_template.html: level_q (frames x levels x 4, w x y z) with scene["levels"][k] =
    {pivot, geoms (indices into scene["tray"]["geoms"])} draws one group per level, turned about its own
    pivot, as SYSTEM.md section 5 asks the seesaw run to record. The single tray_q path stays.
    Checked on a synthetic alternating +/-10 deg seesaw of the 3-level tower.
    - rig.py: each tray on a pivot axle across its middle (posts both sides, knob on the front), at the
    run's level pivots when recorded, else each box's centre; corner uprights clear the boxes at any tilt;
    the tub sits lower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
2026-10-25 Seesaw level spacing from the real holder solids: ~105 mm at +/-25 deg with the tab, ~85 without
    - cad/seesaw_tower.py: tips frame_holder.py's box +/-tilt about a pivot across its middle (ASSUMED at the
    body's centre, mid-height), neighbours opposite, and bisects the pivot-to-pivot pitch that leaves 3 mm
    between neighbours over both half-cycles, with the +X tab and with it cut off.
    20 deg: 89.5 / 74.4; 25 deg: 103.6 / 84.9; 30 deg: 116.7 / 94.7 mm (with tab / without).
    The tab ends (92 mm from the pivot) decide it; SYSTEM.md's 80-100 mm holds only without the tab.
    - out/seesaw_tower.png: three levels at +/-25 deg, 105 mm apart.
    - WORKING_DIMENSIONS.md: the table.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
2026-10-25 Seesaw tower: each level on its own hinge, neighbours in opposite phase (SYSTEM.md 3, 5)
    sim/rocking.py: a "seesaw" stroke turns every box of an inserts: tower (catch pan
    included) into its own body on a Y hinge through the box centre. Lab frame, gravity -Z;
    hinge qpos/qvel written every step from +/-deg * f(t), sign alternating by level
    (constant angular speed with smoothed reversals, or sine). Zones are tested in their
    level's frame; tray-tray contacts are off and clearance() checks neighbouring boxes
    over a cycle with mj_geomDistance; pitch_needed() finds the spacing.
    sorter.py: small hooks only (build the level bodies, drive them, zone frames, record
    level_q and scene["levels"]). Transl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
2026-10-25 SEESAW.md: viewer is Bambu's (PR #13), no edits here; pitch cross-checked against the CAD (PR #14)
2026-10-25 Pantry photo grains: brown, black and wild rice, chia and couscous (sim/GRAINS.md)
    Five new grain kinds from the team's photo of the divided tray, each with
    literature sizes, the photo's colour and an ID confidence. rice, quinoa,
    chickpea and pasta are frozen: the same rng state still gives byte-identical
    XML and dims, so the optimizer's leaderboard stands. Wild rice is one capsule;
    couscous draws one size that scales the whole grain. GRAINS.md has the
    sources, the assumptions, a smoke run on inserts:5mm,2mm and what to caliper.
2026-10-25 white_rice as photographed; the insect-model audit (sim/INSECT_AUDIT.md)
    The user pointed out that the sim's rice isn't the photo's white rice. The
    photo reads 7.2 mm long, so white_rice is a new kind at Riceland's US
    long-grain size (7.2 x 2.1 x 1.7 mm, 21 mg). It passes a 2 mm square at
    83% against rice's 95%. rice stays frozen. The insect audit compares
    insects.py with EntoSieve's real Malaise counts and ranks six proposals;
    nothing in insects.py changed.
2026-10-25 Clumps: a ball of specimens and debris held by breakable bonds that weaken when wet (clumps.py)
    - clumps.py: pack N specimens (insects.py kinds or grain surrogates) plus leaf / twig / dirt
    debris into a ball with a short pre-sim, bond every pair within 0.3 mm with an equality
    (connect by default, or weld), and switch eq_active off once the bond's efc_force load passes
    sigma * r_pair * (1 - k_wet * w), w from spray.py. Weak / medium / strong bond sets.
    - Metrics in results["clumps"]: fraction of specimens free over time, t50 / t90, largest
    cluster left, peak contact force per specimen (overall and while still bonded) against a
    fragility threshold, leaf blinding of screen holes, and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
2026-10-25 Seesaw + vibration: a small fast buzz of the whole tower on top of the alternating seesaw (vib_mm, vib_hz, vib_angle_deg, vib_deg); default amplitude now +/-10 deg
    The buzz goes through sorter.py's translation path (uniform pseudo-force, exact for a
    shared translation, recorded as tray_d); the hinges turn inside that frame. Translation
    runs are untouched, and a seesaw run with vib_mm=0 is unchanged apart from the new
    default deg (10, per SYSTEM.md section 3).
2026-10-25 Real Malaise insect mix: new insect_malaise kinds fitted to EntoSieve's counts
    insect_malaise draws body length from a lognormal fitted to EntoSieve's two
    counted Malaise samples (pooled ML fit, median 1.274 mm, sigma 0.779, 0.3-20
    mm), then the body plan given length. 56-57% under 1.5 mm, 70/28/2% in the
    BugPicker classes. Stratified per-class kinds and MALAISE_MIX presets for the
    optimizer and the clump session. The frozen kinds and PLANS are byte-identical.
2026-10-25 Seesaw: level bodies before the particles (about 20x faster per step); optimizer study 'seesaw' on the alternating stroke
    sorter.py: every contact touches a level's hinge DOF; with the levels after the
    particles the Newton factorization went dense (99 s vs 5.1 s for 1 s of plinko).
    optimize.py: study 'seesaw' searches rocking.py's seesaw: stroke (5-15 deg,
    0.4-6 s, constant speed or sine) and the tower pitch (80-110 mm) for plinko and
    inserts; plinko rocks as one box on one hinge (one_box_seesaw).
2026-10-25 Seesaw CAD fixes: centre-pivot holder (no tab), deep catch pan with a lip, ribs-across inserts; in the sim and the print plan
    - cad/seesaw_holder.py: the holder box with no +X tab and no notches, pivot lugs with 6.2 mm blind holes
    at mid-height; levels clear at ~54 mm pitch at +/-10 deg (was 85-110), so specimens drop half as far
    - seesaw_catch_pan: 20 mm deeper, inward 45 deg lip leaving the 122 x 82 open bottom of the box above
    - sieve_insert.py ACROSS: 5 / 2 mm screens over the whole open bottom, 45 deg border ramps, ridges along Y only
    - sim/designs_holder.py: inserts:5mm_across,2mm_across,pitch=55,holder=seesaw reads all of it from the CAD
    - print plan: the queue and the four parts, s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
2026-10-25 README: mascot header (Malaise sample into a 3-tier sieve) and icon
2026-10-25 Verify under the seesaw: the demo rig on the alternating +/-10 deg seesaw (8 of 18 runs; batch stopped for low memory)
    sim/verify_seesaw.py reruns the demo rig and the demo winners (one box) on
    rocking.py's alternating seesaw, scored by optimize.run_score, reusing
    verify.py's runner. The batch was stopped by Claude Code at 12:53 (Windows
    214 MB free); 8 demo-rig runs, all friction sets, no failures: robust 0.36,
    40% of the quinoa still on 5 mm after 8 s.
2026-10-25 SEESAW.md: a 40 Hz buzz of 0.3 mm or more on the +/-10 deg seesaw clears quinoa, couscous and chia off the 5 mm tray (all 10 grain kinds, one seed)
2026-10-25 docs/PITCH.md: 5-minute demo script draft; README links it
2026-10-25 Sim A/B of the seesaw parts (one seed): quinoa stuck on 5 mm 7/12 -> 1/12, drop 85 -> 55 mm; tower script for the seesaw parts
    - print_plan.md: old inserts:5mm,2mm,pitch=85 vs inserts:5mm_across,2mm_across,pitch=55,holder=seesaw at +/-10 deg,
    71 grains of all 10 kinds; small grains left on 5 mm 20/64 -> 14/64, peak overlaps lower. Seeds 2-3 were stopped
    (the laptop ran low on memory), so it's a direction, not a number
    - seesaw_tower.py: pitch table for 5-25 deg with frame_holder vs seesaw_holder, preview with the new parts
    (not re-rendered yet: stopped on low memory)
    - docs/sessions/bambu.md: status at 12:50
2026-10-25 designs_breaker.py: the breaker layer on top of the seesaw tower; opt_malaise.py: EXPLORATORY clump break-up study
    breaker:open,bar,pin_d,pin_h,pitch,tip (cad/breaker_layer.py's keys and
    rounding) plus under= and tower=; the breaker is the top level, so rocking.py
    rocks it. opt_malaise.py ranks breaker + seesaw (+ buzz) on a clump across
    the three bond sets: break-up, then gentleness, then sort. The clump is the
    grain surrogate: insect clumps blow up in clumps.pack (reported in LOG.md).
    optimize.py: run_job keeps clumps metrics and ignores the clump packing
    model; --screen-seeds / --full-seeds for slow seesaw rounds.
2026-10-25 PLAN.md 13:00: demo configuration = ribs-across seesaw parts + 40 Hz buzz; memory rules
2026-10-25 Optimizer: seesaw study gains the buzz (vib_mm, 40 Hz) and the ribs-across references from round 1; LOG: breaker, malaise setup, insect-clump blocker
2026-10-25 Malaise round 0 (EXPLORATORY): breaker + seesaw + buzz frees a medium-bond clump that sits whole without a breaker
    Leader B-32a7c82c: grid 11.4 mm, pins 1.4 x 6.8 mm round every 8, +/-12 deg 2.5 s
    + 0.35 mm buzz: robust 0.638, 97% free. CAD default 0.287 (0.479 with the
    buzz); no breaker 0.217 (medium bonds: 2% free). Grain-surrogate clump.
2026-10-25 Malaise round 0 headline in README; PLAN: print the optimizer's breaker by 13:50; restore the next-steps heading
2026-10-25 Malaise round 1 (EXPLORATORY): B-87f42099 leads (grid 8.9, short flat pins 2 x 7.6, +/-8 deg 3.5 s + 0.35 mm buzz, robust 0.683); opt_malaise verify; opt README
2026-10-25 Clumps: bond sets placed on measured loads at +/-10 deg (weak 5000, medium 10000, strong 25000 uN/mm); staged relax; insects pack with Newton
    - weak just holds the demo clump up at rest (static max 4530 uN/mm), medium = p99 and strong =
    max of the load over one +/-10 deg seesaw cycle, measured with unbreakable bonds.
    - Packing relax stiffens contacts from 2 ms to the run's own in 4 stages (straight to stiff
    blew up interlocked insect legs); CG blew up packing insects, so they pack with Newton.
    - results bonds carry r_pair; clump_study defaults to +/-10 deg, pitch 85, <= 4 workers.
2026-10-25 CLUMPS.md: the model, bond sets placed on measured loads, the +/-10 deg spray study (4 of 6 runs), and the insect clump
    The plain +/-10 deg seesaw sheds what's loose in the first tilt, then holds the ball still
    (its centre moves < 2 mm in 6 s); spray roughly triples what weak bonds free (49% vs 14%).
    Insect clumps pack now (the optimizer's blocker); legs catching on the grid load them 100x
    over rest. The damage proxy is dominated by the drops between levels.
2026-10-25 Optimizer's malaise breaker #1 (B-32a7c82c) built and sliced: 48 min, 20.9 g; first in the print queue, send by 13:50
2026-10-25 Malaise round 2 (EXPLORATORY): B-31c4ea6d leads (grid 12, round pins 2.8 x 6 every 9, +/-10.5 deg 3.6 s + 0.3 mm buzz, robust 0.700)
2026-10-25 Seesaw round 0: nothing reaches 0.5 on the seesaw alone (quinoa rides the upper tray); malaise verified on fresh clumps: short-pin breaker + buzz holds at 0.63 (94% freed vs 48% with no breaker)
2026-10-25 Verified malaise breaker B-164f355a built and sliced (57 min); PLAN: print this one, not the lucky round-2 leader
2026-10-25 Malaise winners verified on fresh clumps (EXPLORATORY): B-164f355a 0.630 (grid 11.3, round pins 3.1 x 8 at 12.9, +/-7 deg 1.1 s + 0.35 mm buzz), B-87f42099 0.605, B-32a7c82c 0.554
    Winners are verified designs ranked by min(robust seed 0, robust all seeds);
    labels show the real pin spacing (grid nodes), not the pitch target.
2026-10-25 Print queue: the verified malaise breaker B-164f355a first (57 min); don't print the lucky B-31c4ea6d
2026-10-25 CLUMPS.md: breaker + buzz with spray on/off (grains 81 -> 92%, real-mix insects 35 -> 60% freed), strong rows, insect_malaise needs dt 0.0625 ms
    - The plain +/-10 deg seesaw frees 0-1% of medium/strong clumps; the CAD default breaker with
    the 0.3 mm 40 Hz buzz frees 81% dry and 92% with spray, at 3-4x the in-clump peak force.
    - insect_malaise clumps reset in the settle at dt 0.125 ms whatever the contacts, breaker or
    debris; dt 0.0625 ms is stable. On breaker + buzz they free 35% dry, 60% with spray.
    - clumps.py docstring example on the +/-10 deg tower.
2026-10-25 PITCH.md: final numbers and the render-lab run order for the live demo
2026-10-25 PITCH.md: breaker is the optimizer's 11.3 mm grid with 8 mm pins; leaderboard links
2026-10-25 Seesaw round 1: plinko + buzz sorts on the rig's seesaw (P-3bbfc231 0.998 at +/-14 deg 1.9 s + 0.35 mm; P-3b817251 0.997 at +/-10.5 deg 1.5 s + 0.2 mm); ribs-across best without buzz
2026-10-25 README + PITCH: seesaw winners (plinko 4.7/1.5 + buzz at 0.998)
2026-10-25 CLUMPS.md: the printed breaker B-164f355a, spray on/off: grains 92 -> 100%, real-mix insects 25 -> 90% freed in 4 s
2026-10-25 Viewer: see-through frame option (on by default, rigclear=0/1) so the bench tower doesn't hide the trays
    render_site rebuilds a replay when the viewer template or viewer.py is newer than it.
2026-10-25 Multi-layer towers: 4 and 5 sieve trays (5-6 size classes) and 3-4 level gated towers on the seesaw
    - designs_holder.insert_spec builds custom screens from their name, h<hole>b<bar>[_across]
    (optimize.py's naming, sizes as modelled), so plain sorter.py runs any number of custom trays
    - sim/LAYERS.md: size classes from GRAINS.md hole sizes, specs, per-level counts for 8 runs
    (grains and the Malaise insect mix), and next steps; one seed each, uncalibrated
    - render_site/runs_def.py: new first group "More levels (multi-layer)"
    Best: inserts:h4p85b1p35_across,h2p25b1p15_across,h1p75b1p15_across,h1p25b1p15_across,pitch=55,holder=seesaw
    on seesaw deg=10, period 2 s, 0.3 mm 40 Hz buzz: pasta+ch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
2026-10-25 Gated towers can be spaced apart (pitch=), so each level lifts out and seesaws on its own
    designs_gated: opt-in pitch=<mm> (box bottom to box bottom). Default builds are byte-identical. A spaced tower
    reports its boxes like designs_holder, so rocking.py rocks every level about its own middle with neighbours
    alternating. Ramp tower at pitch=70 on that seesaw + 0.4 mm 48 Hz shake: big 15/15 on L1, every rice kind
    57/58 on L2, fines 26/45 in the catch, 6 fines out through the gaps (a skirt per level would keep them).
    Render site: new first group with the spaced gated runs; multi-layer runs from PR #42 follow.
2026-10-28 The whole machine as one model, and the repo as one product
    - cad/product.py: the full assembly (breaker, 5 mm and 2 mm ribs-across sieves, catch pan) on a base with
    pivot posts, driven by two push rods from BugSorter's stage: atan law, R = 56.71 mm, the default 2 cm
    stroke gives +/-10 deg, neighbours alternate. Clearances checked on the real solids; boxes touch at a
    25.4 mm stroke. Renders, checks, GLB, kinematics, and docs/assets/product.stl for GitHub's 3D viewer.
    - cad/seesaw_holder.py: drive-lug variants (_drive_a, _drive_b, catch pan); existing parts unchanged.
    - cad/PRODUCT.md: build sheet (13 printed parts, 11 h 44 min, 457 g; hardware; assembly; assumptions).
    - cad/product_vie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
    [clump_breakup.csv, product.stl]
2026-10-28 Each box moves on its own: boxes: stroke, round and slot screens, and the sift study
    The user: "the boxes are individually shaking it doesnt matter that theyre synced
    what matters is the sifting". So each box of an inserts: tower gets its own motion.
    - boxes.py (--stroke boxes:): per level a tilt about Y (deg, period_s, shape, phase)
    and a vibration (vib_mm, vib_hz, vib_angle_deg, vib_az_deg, vib_phase), slash lists
    top to bottom with the catch pan last. Kinematic, lab frame: slides X/Y/Z then the
    hinge, qpos/qvel written each step plus a feed-forward force for the prescribed
    acceleration; gravcomp on the level bodies. No actuator dynamics.
    - Clearance over every phase combination (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
2026-10-28 Liquid bath for the sim, and EntoSieve rebuilt dry and wet
    sim/liquid.py: a bath with a lab-fixed surface (--liquid water|ethanol:level_mm=..,entrain=..).
    Per particle body, elements (a merged core ellipsoid plus every leg, antenna and wing) get
    buoyancy at the submerged centroid (real volumes, so thickened wings don't float a fly),
    drag against the local liquid with the exact Stokes tensor of each ellipsoid and a
    Schiller-Naumann x Hoelzer-Sommerfeld inertial factor, rotational drag, the Munk moment,
    and added mass integrated implicitly as free-joint inertia (dof_armature, or dof_M0 for
    MuJoCo's simple bodies). Drag diagonals go into dof_damping for stability. entrain sets how
    much of the l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
2026-10-28 The sift study sorts wet: the tower under ethanol, scored at entrain 0, 0.5 and 1
    SYSTEM.md section 3: each box shakes on its own and the optimizer picks its
    motion; the alternating seesaw and its push-rod drive are one option. The dry
    pilot keeps its own settings.
2026-10-28 Fix three bugs the liquid work found
    - clumps.screen_holes: a leaf in a clump on ribs-across inserts raised KeyError
    (it looked in INSERTS only); round and slot screens are now skipped.
    - sorter.py: a state that blows up on every step keeps the clock stuck at one
    step and was never counted as a reset; a step that doesn't advance the clock
    a full step now counts.
    - sieve_system.py: an invalid escape in the docstring.
    A dry boxes run is byte-identical before and after.
2026-10-28 The sift study sorts wet the way BugSorter does: trays in air, sprayed
    Submerged in ethanol, liquid.py sinks the < 2 mm specimens at a median 1.4 mm/s
    (liquid_check.py sink), so a tower needs minutes per sort, as EntoSieve's 6 min
    per plate does, and a 12 s optimizer run would only measure sinking. So the
    study runs the specimens wet from the sample (spray.py wet0 = 1) under the
    design's jets spraying ethanol, at a light and a strong capillary cling.
    The hole ranges widen to 1.8-7.0 and 0.7-2.6 mm: wet specimens lie flat and
    holes cut by body length (ENTOSIEVE.md), so the cuts can need holes near the
    cut lengths. A new reference has EntoSieve-style round holes at 5.0 / 2.0.
    spray.py wet0 a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
